dormeN1506/Trabajo-Practico-Final---Electronica-Digital-3/hardware/esquematico DMA DAC.jpeg

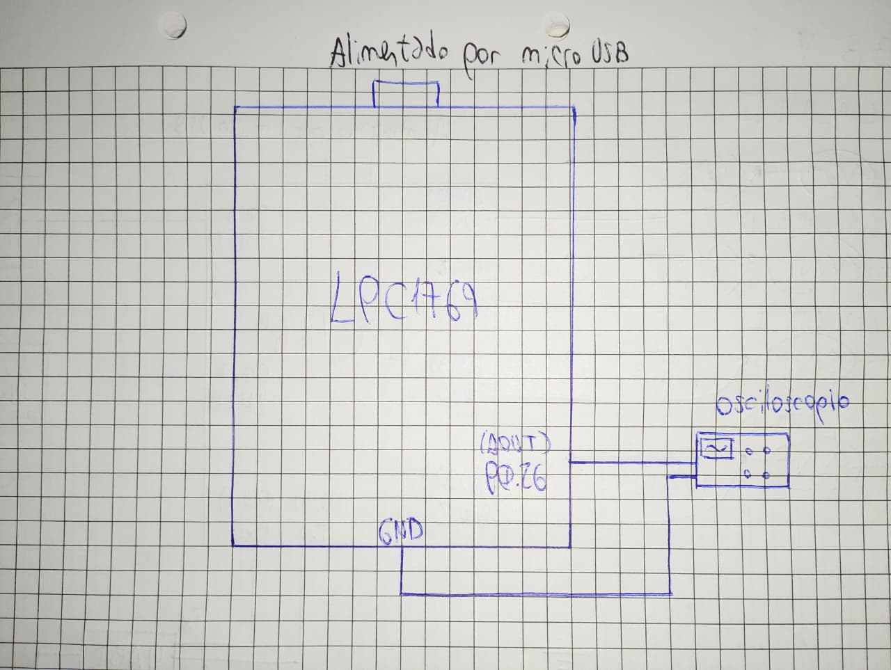
hardware/esquematico DMA DAC.jpeg
