dormeN1506/Trabajo-Practico-Final---Electronica-Digital-3/(commit log)

2026-05-30 feat:nueva division de archivos y defines
2026-05-30 feat: implementacion para procesar datos de un LDR
2026-05-31 feat: implementacion completa con burst a cambiar porque solo tenemos un trigger para 4 ADCs
2026-05-31 feat: solucion para tomar las muestras de los 4 LDR con maquina de estados
2026-06-01 feat: implementacion UART
2026-06-03 bug fixes a la implementacion de uart
    [main.c]
2026-06-04 agregamos archivos nose que hacen
2026-06-19 subida de multimedia
2026-06-19 Subida de GIF
2026-06-19 archivo dma dac
2026-06-19 Acondicionamiento de archivos
2026-06-19 Limpieza de código y últimos agregados al README
